anking/gps-station/firmware/readme.md

# GPS base station firmware for ESP32

Turns an ESP32 and a u-blox ZED-F9P into an RTK base station. It finds and configures the module, surveys or uses a fixed position, and sends RTCM corrections over WiFi, straight to rovers on the same network and to an NTRIP caster such as RTK2go as their backup. There is no Raspberry Pi, .NET or Node.js involved.

**Status:** tested against a simulated ZED-F9P and caster, and built for both boards below, but not yet run on real hardware. That includes updates and reporting, which only run on the board. See [First bench test](#first-bench-test).

## What you need

- An ESP32-C3, ESP32-S3 or classic ESP32 board with 4 MB of flash or more
- A ZED-F9P board with its UART1 pins available, and its antenna
- A [mountpoint reservation on RTK2go](http://rtk2go.com/sample-page/new-reservation/), or another caster, for the backup route

## Wiring

| ZED-F9P | ESP32-C3 Super Mini | ESP32-S3 | Classic ESP32 |
| --- | --- | --- | --- |
| RX1 | GPIO 5 | GPIO 17 | GPIO 17 |
| TX1 | GPIO 6 | GPIO 18 | GPIO 16 |
| GND | G | GND | GND |

On a SparkFun GPS-RTK-SMA, RX1 and TX1 are the pads labelled `RX/MOSI` and `TX/MISO`. Leave `CS` unconnected and the `DSEL` jumper on the back open, or those pads stop being a UART. The `RX2` and `TX2` pads under "RTCM Correction" are the module's second port, and will not work here: this firmware configures the module through UART1.

Both sides use 3.3 V logic, so no level shifter is needed. Power the F9P board from its own USB port, or from the ESP32 board's 5 V pin into the F9P board's 5 V pin, with a USB supply good for 1 A. Do not power it from the ESP32 board's 3.3 V pin, and do not plug in both USB ports while that 5 V wire is connected. To use other pins, change `GPS_TX_PIN` and `GPS_RX_PIN` in [platformio.ini](./platformio.ini).

Any baud rate on the module is fine. The firmware finds it and switches to 230400.

The firmware sets the module up at every start, with `UBX-CFG-VALSET` into RAM: its port, its rate, the RTCM messages and the survey or fixed position. That is the only way u-blox documents from module firmware HPG 1.50 on; the older `CFG-PRT`, `CFG-MSG`, `CFG-RATE` and `CFG-TMODE3` messages are not used. Nothing is saved in the module except the second band, when you turn it on from the page. So a module whose settings were wiped, as a firmware update with chip erase does, works straight away.

## Flash it

With [PlatformIO](https://platformio.org/) installed:

```sh
cd firmware
pio run -e esp32-c3 -t upload     # or -e esp32-s3, -e esp32dev
pio device monitor
```

## Set it up

1. On first start the board creates a WiFi network called `gps-base-XXXX`, with the password `gps-base-setup`.
2. Join it and open `http://192.168.4.1`.
3. Fill in your WiFi network, the backup caster details and a password for the page, then save. The board restarts and joins your network.
4. Find its address in your router's device list under `gps-base`, or in the serial monitor, and open it. Log in with any user name and the page password.

If it cannot join your network for 2 minutes, the setup network comes back as well, so a changed router cannot lock it out. Holding the BOOT button for 5 seconds erases all settings.

## Using it

The page shows what it is doing, and in plain words what is wrong if anything is. All settings, and the base mode, survive a restart. It has these tabs:

- **Overview:** whether corrections are going out, to whom, the satellites in use, how many signals are heard on each band, the base's position, a survey's progress, and the WiFi signal.
- **Map:** the base on satellite or street imagery. The map library is stored on the board, so only the imagery comes from the internet, through your phone or computer. On the setup network there is none.
- **Satellites:**
  - where each satellite is in the sky and how strong its signal is. Satellites missing from one side of the sky mean something blocks the antenna there;
  - **Bands:** for each constellation, how many signals are heard on its first band and on its second, how strong they are, and whether the module is set to track each band. See [Two bands](#two-bands).
- **Position:** survey or fixed. For a fixed position:
  - a map to put the base on: tap where the antenna is, or drag the red pin. The blue dot is where the module says it is, and the page says how far apart the two are;
  - **Use the current position** copies where the module is now, to the full precision it reports, and **Use the current height** copies just its height;
  - the height can be given above sea level instead, and is turned into the height above the ellipsoid the module needs.
- **Settings** and **Maintenance:** WiFi, the backup caster, monitoring, updates, installing a firmware file and restarting.

**Survey or fixed position:** corrections make a rover precise *relative to the base*, so the rover's position is only as right and as repeatable as the base's.

- **Survey** works out the position by averaging. It is quick to set up, but the default of 60 seconds and 3 m leaves the base up to metres off, and the result changes with every survey. Anything saved in rover coordinates, such as a mowing boundary, moves with it.
- **Fixed** uses a position you give it. Use this for anything that must line up from day to day. Get the position from a long survey, or from a day of raw data sent to a free service such as [OPUS](https://geodesy.noaa.gov/OPUS/) or [CSRS-PPP](https://webapp.csrs-scrs.nrcan-rncan.gc.ca/geod/tools-outils/ppp.php), or pick it on the map. The antenna must not move afterwards.
  - **On the map:** a point picked there is only as right as the imagery, often a metre or so out. The rovers' positions are then out by the same, but the same every day, which is what matters for anything saved in rover coordinates. Many metres from where the module says it is can make RTK fixed harder for rovers to reach, and the page warns from 5 m.
  - **Heights** are above the ellipsoid, the smooth shape GPS measures from, not above sea level. The two differ by tens of metres depending on where you are: the module's own figure for here is on the page. A survey's height, shown as Height (ellipsoid) on the Overview, is already the right kind. A height from a map or a sign is above sea level: enter it in the sea level box. A height a few metres out moves the rovers' heights, not where they are on the ground.

### Two bands

A rover gets an RTK fix quickly and reliably only when the corrections carry two bands from each satellite: L1 and L2 for GPS and GLONASS, E1 and E5b for Galileo, and B1I and B2I for BeiDou. With the first band alone it can stay at RTK float for a long time, or never fix. The corrections carry only the bands the base hears.

- **If the second band is off in the module,** the Bands card says so and offers **Turn the second band on**. That turns on both bands of every constellation, leaves the constellations themselves as they are, and saves it in the module, so it lasts through a power cut. The module restarts its tracking, so corrections pause for a few seconds. If the module will not save it, it is on until the module loses power, and the page says so. The firmware never changes this by itself.
- **If the second band is on but little is heard on it,** the antenna is probably made for L1 only, or its cable or a splitter loses the higher band. The fix is a multi-band antenna.

Either way, once the base has heard fewer than half as many second-band signals as first-band ones for about 15 seconds, the page and the monitoring service show a warning, `SINGLE_BAND`. It judges only with at least 8 first-band signals heard.

**On an ESP32-C3 Super Mini:** many of these boards are reported to lose WiFi at full power, so this build caps it at 8.5 dBm. That shortens its range, so check the signal on the page with the board where it will finally sit. If it needs more and this board copes, raise `WIFI_MAX_TX_POWER` in [platformio.ini](./platformio.ini).

## How corrections reach a rover

The board sends every correction two ways at once, so a rover can change route at any time:

- **Direct over WiFi:** a rover on the same network connects to this board on port 2101. This needs no internet, password or reservation. Give the board a fixed address on your router, and put that address in the rover's settings, as `NTRIP_DIRECT_SERVER` on the [mower](https://github.com/anking/gps-rider). The page shows the address and whether a rover is connected.
- **Backup caster:** the board also uploads to RTK2go, which needs the internet and the mountpoint password. A rover uses this when it cannot reach the board directly. Leave these settings empty to run with no backup.

Up to two rovers can connect directly. When a third does, the one connected longest is dropped, because a rover that lost its WiFi has no way to say so. A rover that cannot keep up is also dropped, and connects again, so it can never hold up the module or the upload.

Anyone on your WiFi can read the direct stream, which includes the base's exact position. So can anyone at all on RTK2go, while it is set up. Do not forward port 2101 on your router.

## Monitoring and over-the-air updates

The base reports to the [Rider monitoring service](https://rider.solvitcorp.com) over MQTT, and keeps its firmware up to date from there, the same way the solar tracker does. Both are on by default, and only need the board to be on your network.

**Reporting:** the status shown on this page goes to `mqtt.solvitcorp.com` every 5 seconds, including the base's exact position. That broker has no login yet, so anyone connecting to it could read that. To turn reporting off, empty the broker field in the settings. To use a broker with a login, fill in its user and password there.

**Automatic updates:** the board asks the service on start and every 10 minutes. If a newer release is active it installs it and restarts, which drops the corrections for under a minute. Untick the setting to install only when you press **Check for update**, or when someone asks from the service.

- It first checks that the image is this project's, and is for this chip.
- The new version has to run for a minute with a network connection. If it keeps crashing before that, the board goes back to the previous version by itself, and does not install that version again unless someone asks for it by name.
- Firmware comes over plain HTTP, like the tracker's, because an ESP32 cannot reliably hold TLS through a large download. The board checks the image is sound, but not who built it.

To publish a new version, raise `PROJECT_VER` in [CMakeLists.txt](./CMakeLists.txt), build it, and upload `.pio/build/<board>/firmware.bin` on the service's Firmware page. Each chip needs its own build, and the service holds one active release, so all base stations need the same chip.

**By hand:** the page also accepts a `firmware.bin` directly, so a board can be updated without the service.

## How it treats the caster

Public casters count failed connections per IP and ban the address, so the firmware is careful with them:

- Attempts back off from 15 seconds to 15 minutes. The delay only resets after a connection has lasted a minute.
- After a reply that says the IP is banned, it waits an hour.
- It connects only while the module is producing corrections, because a source that connects and sends nothing is dropped and counted as bad.
- It never connects with empty settings. The base carries on without it, serving rovers directly, and the page says so.
- Only whole frames with a valid checksum are sent, as soon as they are complete.

## First bench test

The simulator cannot check real radio, UART timing or WiFi. Before relying on this:

1. Flash it and do the setup above, with the antenna outdoors.
2. The page should go through "Looking for the GPS module" and "Surveying" to "Streaming corrections".
3. Check that your mountpoint appears in the [RTK2go status list](http://rtk2go.com:2101/SNIP::STATUS).
4. Set the rover's `NTRIP_DIRECT_SERVER` to the address on the page. The page should show the rover connected, and the rover should reach RTK Fixed.
5. Pull the WiFi or restart your router, and power cycle the F9P. The page should report it and recover without help each time, and the rover should reconnect by itself.
6. Check that the base appears on the [monitoring service](https://rider.solvitcorp.com), on the map and with its version.
7. Upload a build with a higher version, make it active, and press **Check for update** on the page. The board should install it, restart, and report the new version. Corrections should come back by themselves.
8. Do the same with a build that crashes at start (add `abort();` to the top of `app_main`). The board should come back on the version before it, and report that it will not install that one again. **Keep USB access to the board for this test.**

## Development

The base station's logic is in [src/core](./src/core), which is portable C. The rest of `src/` connects it to the ESP32: UART, WiFi, flash, the web UI, updates ([ota.c](./src/ota.c)) and reporting ([mqtt_link.c](./src/mqtt_link.c)).

To run it on a Linux PC against a simulated module, caster and rover:

```sh
make -C host test    # unit tests
make -C host e2e     # end-to-end scenarios, Linux only
```

These run under AddressSanitizer and exercise the same C code as the firmware, apart from the serial port, the web UI, and the MQTT and update code, which only runs on the board.

On newer kernels AddressSanitizer can crash at random at startup, printing only `AddressSanitizer:DEADLYSIGNAL`, because of how widely addresses are randomised. Run them with randomisation off: `setarch $(uname -m) -R make -C host e2e`. In Docker that also needs `--security-opt seccomp=unconfined`.
