anking/gps-station/enclosure/service-door-v4/README.md

# GPS-станция V4 — ровная дверца, усиления крыши, центрирующая посадка

Предыдущие V1–V3 сохранены отдельно. В V4 семь основных печатных деталей. Пользовательский ESP cradle, сдвижная полка, плоский внутренний пол и глухие крепления сохранены.

## Изменения

* Удалены **две оставшиеся прямоугольные накладки с наружной поверхности дверцы**. Сохранены только её тонкое периметральное ребро и внутренний упор выдвижной полки. Покупные петли и защёлки пользователь размещает самостоятельно.
* **Четыре ската крыши сохраняют исходные ровные наружные плоскости.** Верхушки язычков укорочены, корни обрезаны по наружному контуру крыши. Они больше не выступают через её поверхность. Это не замена четырёхскатной крыши плоской горизонтальной крышкой.
* У каждого из четырёх корней защёлок добавлены **два внутренних ребра толщиной 2.4 мм**, всего восемь. Остальная крыша целиком не утолщалась. По CAD добавленный объём локального усиления составляет примерно **232 мм³ = 0.23 см³**. Расход филамента с поддержками и заполнением зависит от настроек печати.
* В нижнем наружном основании теперь есть **центрирующее гнездо глубиной 2.5 мм** под исходный наружный диаметр адаптера **64 мм**. Диаметр гнезда **64.6 мм**, то есть зазор **0.3 мм на сторону**, без натяга. На входе фаска 0.5 мм.

## Как садится адаптер

Внешний выступ основания увеличен до **Ø70 × 12.5 мм**. Верхние 2.5 мм существующего адаптера входят в гнездо. Точная форма и резьба адаптера сохранены; добавлять отдельный шип или перемоделировать адаптер не потребовалось.

При полностью вставленном адаптере его верхний торец **касается плоского дна гнезда**. Это предусмотренный упор, поэтому осевого зазора между этими поверхностями в собранной CAD-модели нет. Боковой зазор сохраняется: он помогает собрать детали после печати и центрирует их. Объёмного пересечения деталей в номинальном положении нет. Болты удерживают соединение, а посадка уменьшает возможность бокового сдвига.

Три глухих крепления M3 открываются со стороны дна гнезда; карманы под термовставки Ø4.2 × 5 мм и глухой пилот Ø2.5 глубиной 8 мм от посадочного торца сохранены. До внутреннего пола остаётся минимум **6 мм сплошного материала**. Карман сверить с конкретной вставкой. Начальный крепёж — M3 × 10 со стороны открытой резьбовой полости адаптера; проверить фактическую длину и отсутствие упора в дно отверстия.

**`post_register_test.stl`** — небольшая проба самого гнезда; приложить к уже напечатанному адаптеру до печати полного корпуса. В пробе видны отверстия, поскольку это обрезанный тонкий образец. В полноценном корпусе они глухие. Посадку 0.3 мм на сторону при необходимости скорректировать под принтер.

## Крыша

Защёлки остаются встроенными, без болтов: ширина язычка 18, толщина 1.6, длина до корня 21.1 мм. Нижние лапки оттягиваются наружу для снятия крыши. Небольшие внутренние рёбра поддерживают корень; они не заменяют проверку деформации и долговечности пластика.

Сначала проверить `roof_clip_test.stl` и `roof_catch_test.stl`, затем полную крышу с реальной прокладкой. Выбрать ориентацию и поддержки в слайсере; не повредить язычки при удалении поддержек. Свойства зависят от материала и направления слоёв.

## Файлы и Onshape

* `output/gps_station_service_door_v4.step` — основная сборка из семи тел; в Onshape **+ → Import → Combine to a single Part Studio**.
* `output/layout_with_reference_items.step` — сборка плюс приблизительные габариты оборудования; `REFERENCE` не печатать.
* Основные STL: `body`, `door`, `shelf`, `electronics_panel`, `esp_cradle`, `roof`, `post_adapter`.
* `preview.png` — общий вид, `mechanism_detail.png` — разрез посадки адаптера и корень защёлки, `roof_detail.png` — крыша снизу.
* Остальные файлы с `test`/`coupon` — пробные детали для посадок, не части основной сборки.
* STEP содержит редактируемые твёрдые тела, **без нативного дерева параметров Onshape**. Исходники CadQuery 2.8 и `parameters.json` сохранены; часть компоновочных размеров задана в `build.py`.

Слайдеры V3 сохранены: полка 4 мм, слот 4.6 мм, зазор 0.3 мм сверху, снизу и по бокам. Задние упоры ограничивают глубину, внутренний бортик закрытой дверцы ограничивает выдвижение до 1 мм. При открытой дверце полка вытаскивается без винтов; отсоединить проходящие кабели.

Powerbank пока принят 120 × 80 × 25 мм, моток Ø76 × 14 мм — проверить реальные размеры до окончательной печати. Площадка антенны 42 × 42 мм.

Пазы крыши и дверцы: 2.4 × 1.4 мм, шнур Ø2 мм, суммарно около 1.08 м без запаса; купить примерно 1.5 м. В полу сохранён отдельный кабельный ввод Ø16.2 для герметичного сальника. Это отверстие не относится к глухому креплению к столбу.

## Проверки и печать

Проверяются корректность и отсутствие пересечений семи тел, STEP экспорт/импорт, замкнутость печатных сеток, неизменность исходного cradle, плоский пол и глухие крепления, сдвиг полки, попадание крыши в исходные наружные плоскости, боковая посадка и торцевой упор адаптера. Проверки не являются расчётом усилия защёлок, прочности вставок, усталости пластика или водозащиты.

Печатать сначала малые образцы. После сборки проверить пустой корпус с салфеткой внутри под дождём/обливом, без электроники и питания. IP-рейтинг не заявлен. Поддержки и ориентацию корпуса с наружным нижним выступом выбирать в слайсере, проверяя каналы и поверхности уплотнения.

```powershell
.\.cad-venv\Scripts\python.exe enclosure\service-door-v4\build.py
.\.cad-venv\Scripts\python.exe enclosure\service-door-v4\render.py
.\.cad-venv\Scripts\python.exe enclosure\service-door-v4\verify.py
```
