anking/gps-station/enclosure/service-door-v1/README.md

# GPS-станция с боковой дверцей — service-door-v1

Первая CAD-версия для проверки посадок. Поддон powerbank убран. Печатные детали — семь отдельных тел; платы и powerbank доступны через одну боковую дверцу. Исходные пользовательские STEP сохранены без изменений в `inputs/`.

## Что открывать

* `output/gps_station_service_door_v1.step` — семь печатных деталей в собранном положении. В Onshape: **Create → Import files → Combine to a single Part Studio**. STEP содержит редактируемые твёрдые тела, **без исходного дерева эскизов и параметров Onshape**.
* `output/layout_with_reference_items.step` — та же компоновка плюс приблизительные объёмы powerbank, плат, USB-штекера, мотка и антенны. Детали с `REFERENCE` не печатать.
* Семь STL с именами `body`, `door`, `shelf`, `electronics_panel`, `esp_cradle`, `roof`, `post_adapter` — отдельные детали, уже опущены на плоскость печати. STL служит для печати, STEP — для редактирования геометрии.
* `output/preview.png` — изображение CAD-геометрии. Покупная фурнитура, провода и антенна показаны условно; модель отверстий фурнитуры ещё не определена.
* `parameters.json` и `build.py` — исходник CadQuery 2.8. Основные размеры заданы в JSON, часть компоновочных координат — в исходнике. После изменения размеров необходимо повторить проверки; это не готовая параметрическая модель Onshape.

## Компоновка и размеры, мм

| Элемент | Размер / положение |
|---|---|
| Основная оболочка | 170 ширина × 120 глубина × 112 высота |
| Оболочка с наружными площадками фурнитуры | **218 × 132 × 112** |
| Крыша | 182 × 132, подъём 35, верхняя площадка 42 × 42 |
| Собранные печатные части, с креплением на столб | примерно **218 × 138 × 175**, без покупной фурнитуры и антенны |
| Дверца | около 179 × 108, толщина основной стенки 4, с рёбрами и площадками до 12 |
| Проём дверцы | 154 × 96, скруглённые углы |
| Полка | 152 × 104, нижняя плоскость Z=49, толщина 4 |
| Панель плат | 82 × 49, четыре доступных винта крепления |
| Powerbank, условный | **120 × 80 × 25**, опоры на Z=9 |
| Моток кабеля, условный | **Ø76 × 14**, на втором этаже справа |
| USB-штекер, условный | 22 × 12 × 8, у короткого правого торца powerbank |
| GPS | 44 × 43.2; шаг четырёх отверстий **37.75 × 37.75**, измерен из пользовательского STEP основания |
| ESP32 | 18 × 24.7, без припаянных штырьков |
| Крепление на столб | пользовательское Ø64 × 28; настоящая геометрия резьбы сохранена |

Оба этажа находятся в общей рамке, чтобы стык корпусов не пересекал контур уплотнения дверцы. Крыша, дверца, полка, панель, cradle ESP32 и адаптер столба снимаются отдельно. Крышу обычно снимать не требуется. Powerbank удерживается ремешком на неподвижных опорах; после отключения USB и ремешка его можно вынуть через дверцу. Полку и панель можно вынуть через тот же проём, предварительно отсоединив кабели.

**Толщина powerbank и размеры мотка пока не измерены.** При выбранной компоновке геометрический промежуток от опор до полки — 40 мм, но нужен запас на провода, ремешок и установку. Не считать 40 мм допустимой окончательной толщиной аккумулятора. Уточнить реальный USB-штекер и допустимые радиусы изгиба кабелей.

## Выбранная фурнитура

**Петли:** Piutouyar 1 inch, 25 × 25 в раскрытом виде, 304 stainless steel, отверстия по описанию Ø3.35. ASIN **B09LHJ95YS**, две штуки. https://www.amazon.com/dp/B09LHJ95YS

**Защёлки:** модель с пользовательской картинки, красная ручка и регулируемая скоба. Указанный общий размер 3.5 inch = **88.9**, ручка около 0.7 inch = **17.78**, ответная часть ориентировочно 18.29 × 15.24. Две штуки. Это **не** Sugatsune SCC-TF30, под который делался предыдущий подбор.

На картинке защёлок не даны межцентровые расстояния отверстий. Для выбранных петель найден размер отверстий, но не подтверждён их шаг. Поэтому **монтажные площадки фурнитуры намеренно оставлены сплошными**, вместо выдуманной сетки отверстий. Изображение фурнитуры в preview — габаритная схема.

Порядок подгонки:

1. Напечатать пробный участок либо примерить фурнитуру к распечатанному эскизу площадок до печати большого корпуса.
2. Приложить реальные петли и защёлки, проверить положение оси петли и закрытой скобы при установленной прокладке.
3. Перенести фактические центры отверстий в Onshape или разметить их непосредственно по деталям. Проверить боковой зазор и открывание до сверления.
4. Петли крепить винтами M3 с гайками на наружных площадках, если подтвердится диаметр отверстий. Размер крепежа защёлок подобрать по реальным отверстиям, а не по длинным саморезам из комплекта.
5. Площадки защёлок на самой дверце — глухие наружные усиления. **Глубина сверления от внешней поверхности не больше 6 мм**: не пробивать стенку дверцы в сухую полость. Возможны подходящие короткие винты для пластика или закладные вставки после проверки их длины. Сквозные отверстия с гайками допустимы на наружных крыльях, за контуром прокладки.

Полное совпадение фурнитуры и положение её оси можно подтвердить только по реальным деталям или полному чертежу. Проверка открывания CAD использует предварительную ось; не доказывает совместимость конкретной петли до примерки. Если нужны полностью готовые отверстия, нужны их межцентровые размеры.

## Уплотнение и кабели

* Дверца: один непрерывный паз по рамке, 2.4 ширина × 1.4 глубина, под круглый силиконовый шнур **Ø2**, длина по средней линии примерно **515 мм**.
* Крыша: отдельный паз того же сечения, длина около **557 мм**.
* Суммарно требуется около **1.08 м шнура** без запаса; купить **1.5 м**. Ранее обсуждавшихся двух футов хватит только на один контур, не на оба.
* Зазор защёлок настроить так, чтобы дверца сжимала шнур равномерно без заметного изгиба рамки. Номинальное сжатие при полном контакте — 30%; реальное зависит от печати и шнура.
* USB-кабель проходит через отверстие полки 24 × 14. Второе отверстие 22 × 16 предназначено для антенного кабеля, опускающегося к нижнему вводу.
* В полу есть один ввод Ø16.2 под покупной кабельный сальник для антенного кабеля. Проверить монтажный диаметр сальника, длину резьбы и диапазон обжима по фактическому кабелю. Для готового SMA-штекера может потребоваться разъёмный сальник. Шайба и гайка должны помещаться в отведённом месте; в CAD их точных моделей нет.
* После выхода снизу антенный кабель проходит снаружи по задней стороне к антенне. Закрепить его отдельными наружными клипсами; клипсы пока не моделировались. Перед разъединением крыши отсоединить кабель или освободить его запас.
* Четыре винта крыши проходят внутри верхнего контура уплотнения, поэтому им требуются **уплотняющие шайбы под головками** на плоских бобышках. Аналогично герметизировать три утопленных крепежа адаптера столба: они проходят через пол.
* Плоская площадка антенны 42 × 42 не содержит отверстий, поскольку её крепление неизвестно. Размер площадки не определяет требования антенны к металлической подложке; учитывать документацию именно вашей антенны.

Это прототип без подтверждённой степени IP. Проверить пустой корпус с бумажной салфеткой внутри, без электроники и питания, в реальной ориентации под дождём/обливом. Проверять также печатные стенки, стык шнура, ввод и все проходные винты. Конденсат и нагрев на солнце в этой версии не проверялись.

## Остальной крепёж

Предварительные размеры, уточнить по реальной высоте головок и шайб:

* адаптер столба: 3 × M3 примерно 16 мм, гайки со стороны внутренности адаптера; отверстия адаптера увеличены с 3 до 3.3, посадочные места головок в полу Ø6.4 глубиной 2;
* крыша: 4 × M3 около 20 мм с уплотняющими шайбами, в глухие пилоты Ø2.5 под подходящий пластиковой резьбе винт;
* полка: 4 × M3 около 6 мм, в пилоты опор;
* панель плат: 4 × M3 около 8 мм, в глухие задние бобышки;
* GPS: 4 × M2.5 около 6 мм, пилоты Ø2.1 в стойках; убедиться, что отверстия вашей платы соответствуют изменённому основанию;
* cradle ESP32: 2 × M3 около 6 мм; плату удерживает узкая неэлектропроводящая стяжка через пазы, не перекрывающая кнопки и антенну;
* мягкий ремешок для powerbank, отдельный ремешок для мотка.

Пилоты в пластике не являются смоделированной метрической резьбой. Выбранные винты пробовать на образце. Не ставить комплектные саморезы длиной 25 мм в дверцу толщиной 4 мм.

## Печать и проверка

Сначала печатать `seal_fit_coupon.stl`, `gland_fit_coupon.stl`, `electronics_panel.stl` и `esp_cradle.stl`, примерять детали. Большой корпус имеет ширину **218 мм** с крыльями: проверить полезную площадь принтера с учётом юбки/брима. STL корпуса стоит дном вниз. У крыши, верхней перемычки бокового проёма и наружных крыльев могут потребоваться поддержки. Проверить послойный просмотр; не считать комплект поддержек автоматически правильным. Уплотняющие поверхности не должны иметь остатков поддержек и грубых швов.

Для наружной установки предполагается ASA и хорошее сплавление слоёв. Окончательные режимы зависят от принтера и материала. В качестве пробной настройки: слой 0.2, 5–6 периметров, 6 сплошных слоёв сверху/снизу и 30–40% заполнение. Эти режимы не гарантируют водонепроницаемость.

`verification.json` содержит проверки: одна корректная связная твёрдая деталь на каждый STL, отсутствие объёмных пересечений семи деталей и условных габаритов оборудования, STEP экспорт/импорт с сохранением объёма, выборочная проверка поворота дверцы и проходных габаритов полки/панели. Это не расчёт прочности, не проверка реальных компонентов и не испытание на дождь.

Исходник воспроизводится из корня проекта:

```powershell
.\.cad-venv\Scripts\python.exe enclosure\service-door-v1\build.py
.\.cad-venv\Scripts\python.exe enclosure\service-door-v1\render.py
.\.cad-venv\Scripts\python.exe enclosure\service-door-v1\verify.py
```

Официальная справка по импорту STEP: https://cad.onshape.com/help/Content/Document/importing_files.htm
