anking/gps-station/enclosure/service-door-v2/README.md

# GPS-станция — service-door-v2

Новая редакция после пользовательских правок. Версия `service-door-v1` сохранена отдельно.

## Изменения

1. **Крыша без винтов.** Четыре встроенных гибких язычка направлены вниз под свесом крыши; их зацепы защёлкиваются под наружные выступы корпуса. Старые винтовые отверстия, верхние стойки и площадки головок удалены. Паз под уплотнитель крыши сохранён непрерывным.
2. **Убраны только уши под петли слева**, а также накладки петель на дверце. Площадки под ответные части двух выбранных прижимных защёлок справа сохранены, как отдельно подтвердил пользователь. Петли и их отверстия пользователь размещает самостоятельно.
3. **Вернули исходный пользовательский ESP cradle.** Взята деталь `gps_station_B - esp_cradle.step` из пользовательской папки. Она скопирована в `inputs/esp_cradle_user_original.step` и только повёрнута/перенесена, без изменения удерживающих элементов, формы и отверстий. Крепление на панели перенесено под её фактический шаг **31.7 мм**. Геометрия оригинала не перемоделировалась.

## Файлы

* `output/gps_station_service_door_v2.step` — семь печатных тел в собранном положении, для импорта в Onshape: **+ → Import → Combine to a single Part Studio**.
* `output/layout_with_reference_items.step` — дополнительно приблизительные объёмы плат, powerbank, USB-штекера, мотка и антенны. Детали `REFERENCE` не печатать.
* `body.stl`, `door.stl`, `shelf.stl`, `electronics_panel.stl`, `esp_cradle.stl`, `roof.stl`, `post_adapter.stl` — отдельные печатные детали.
* `roof_clip_test.stl` и `roof_catch_test.stl` — небольшие образцы гибкого зацепа и ответного выступа. **Их рекомендуется напечатать первыми** и проверить защёлкивание, усилие освобождения и зазор. Это отдельные пробы, не дополнительные детали окончательной сборки.
* `seal_fit_coupon.stl`, `gland_fit_coupon.stl` — пробы паза уплотнения и кабельного ввода.
* `preview.png` — общий вид CAD. Дверца на правой картинке показана снятой, поскольку петли теперь определяет пользователь. Покупные прижимные защёлки изображены условно.
* `roof_detail.png` — нижние защёлки крыши крупно.
* `verification.json` — результаты проверки тел, пересечений, импорта/экспорта STEP и печатных сеток.

STEP содержит редактируемые твёрдые тела, но **не нативную историю эскизов/параметров Onshape**. Исходник — CadQuery 2.8 (`build.py`, `parameters.json`). Основные размеры заданы в JSON, компоновочные координаты и геометрия зацепов частично заданы непосредственно в исходнике. После любых изменений повторить проверки.

## Крыша и зацепы

Четыре язычка шириной 18 мм, толщиной 1.6 мм, полной длиной до корня 23 мм расположены на левой и правой стенках, по два с каждой стороны. Геометрическое перекрытие удерживающих граней — 0.8 мм; вертикальный люфт между зацепом и ответным выступом в полностью посаженной геометрии — 0.15 мм. Эти размеры являются исходной пробой для принтера, а не подтверждённой характеристикой серийного замка.

При надевании крыши снизу работают наклонные заходные грани. Для снятия **оттянуть нижние свободные концы язычков наружу** и приподнять крышу; сначала освободить пару с одного края, затем оставшуюся пару. За язычки удобно зацепиться выступающими нижними лапками. Не отгибать их дальше необходимого. Не срезать язычки при удалении поддержек.

Проверка CAD подтверждает закрытое положение без объёмного пересечения, но **не моделирует упругое защёлкивание, усталость материала, удерживающее усилие и реальный прижим прокладки**. Это нужно проверить на образцах и затем на крыше. Условный образец может отличаться по поведению от полной крыши из-за ориентации слоёв; использовать соответствующий материал и учитывать направление печати. Подгонка может потребовать изменения зацепа, толщины язычка или зазора в исходнике.

Полная крыша имеет выступающие вниз защёлки. Её ориентацию и поддержки необходимо выбрать в слайсере: автоматически опущенное на стол положение STL не означает, что поддержки не нужны. Особенно проверить опору скатов, основания язычков и чистоту пазов. Для наружной установки предполагается подходящий материал, например ASA; механические свойства зависят от печати.

## Размеры и остальная конструкция

* Главный корпус: **170 × 120 × 112 мм**.
* Корпус с оставшимися площадками защёлок и небольшими ответными выступами крыши: около **197.1 × 132 × 112 мм**.
* Дверца: **176 × 108 мм**, общая толщина с усилениями до 12 мм.
* Крыша со свесами и нижними язычками: около **182.8 × 132 × 55 мм**. Высота крыши над верхом корпуса остаётся 35 мм; зацепы уходят вниз.
* Верхняя площадка под антенну: **42 × 42 мм**, без отверстий, способ крепления антенны ещё не задан.
* Powerbank: условно **120 × 80 × 25 мм**, неподвижные опоры и ремешок. Выдвижного поддона нет.
* Моток антенного кабеля: условно **Ø76 × 14 мм**. Эти два размера по-прежнему требуют проверки по реальным предметам.
* Полка, панель плат, cradle, крыша и адаптер столба остаются съёмными. Винты крепления GPS доступны со стороны бокового проёма.
* Стойки GPS: шаг **37.75 × 37.75 мм** из пользовательского STEP основания.
* Резьбовой адаптер столба — исходная пользовательская геометрия, перевёрнутая отверстием вниз; три отверстия увеличены до 3.3 мм, как в v1.

Cradle в STEP сборки ориентирован вертикально на панели. Это та же исходная деталь размером 22.6 × 37 × 8.4 мм: направление осей и положение изменены, форма сохранена. Для печати её основание уже повернуто к столу. Пилоты крепления на панели — Ø2.5, два винта M3 ориентировочно 6 мм, с проверкой фактической длины. Удерживающие элементы платы уже присутствуют в исходном пользовательском cradle.

## Уплотнение и вводы

Пазы дверцы и крыши: **2.4 мм ширина × 1.4 мм глубина**, круглый силиконовый шнур **Ø2 мм**. Длины по средней линии около 515 мм и 557 мм; суммарно купить примерно **1.5 м с запасом**. Стык шнура выполнить согласно рекомендации поставщика материала.

В крыше теперь нет проходных винтов. Три утопленных крепежа адаптера столба в полу и нижний кабельный ввод всё ещё требуют герметизации. Ввод — Ø16.2, под выбранный покупной сальник; размер монтажной резьбы, длину хвостовика, гайку и обжим кабеля проверить по реальному сальнику.

USB проходит через полку; антенный кабель через отдельный проход опускается к нижнему вводу и затем идёт снаружи к крыше. Перед снятием крыши освободить кабель антенны, чтобы не нагружать разъём.

Прижимные защёлки дверцы и их отверстия по-прежнему подгоняются по реальным деталям: на присланной картинке нет межцентровых расстояний отверстий. Наружные площадки дверцы сверлить глухо, не глубже 6 мм, чтобы не пробить сухую полость. Не ставить длинные саморезы из комплекта непосредственно в тонкую стенку.

Это **прототип без подтверждённой степени IP**. После проверки защёлок проверить пустой собранный корпус с салфеткой внутри в реальной ориентации под дождём/обливом, без электроники и питания. Отдельно проверить равномерность сжатия прокладки: геометрическая посадка крыши сама по себе не гарантирует защиту от воды.

## Проверки и воспроизведение

Проверяются семь корректных связных тел, отсутствие пересечений в собранном положении, условные габариты оборудования, сохранение объёма после STEP экспорт/импорт, проход полки и панели через проём, соответствие объёма и граней cradle оригиналу, замкнутость печатных сеток. Открывание на петлях больше не проверяется, поскольку геометрии петель нет.

Из корня проекта:

```powershell
.\.cad-venv\Scripts\python.exe enclosure\service-door-v2\build.py
.\.cad-venv\Scripts\python.exe enclosure\service-door-v2\render.py
.\.cad-venv\Scripts\python.exe enclosure\service-door-v2\verify.py
```
