anking/gps-station/enclosure/service-door-v4/inputs/post_adapter_original.step

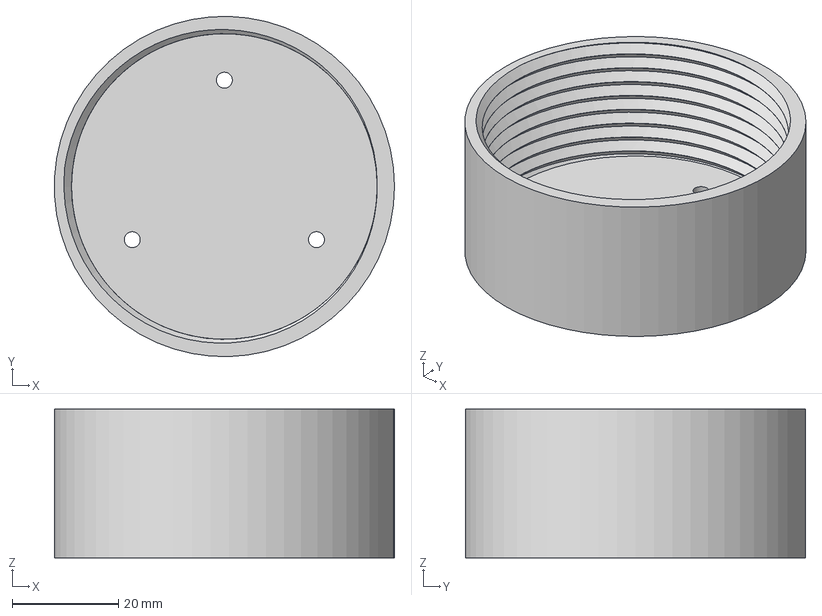
[picture p1: CAD file, 2026-11-09]
enclosure/service-door-v4/inputs/post_adapter_original.step
64.0 x 64.0 x 28.0 mm
