anking/gps-station/enclosure/service-door-v2/inputs/user_base_reference.step

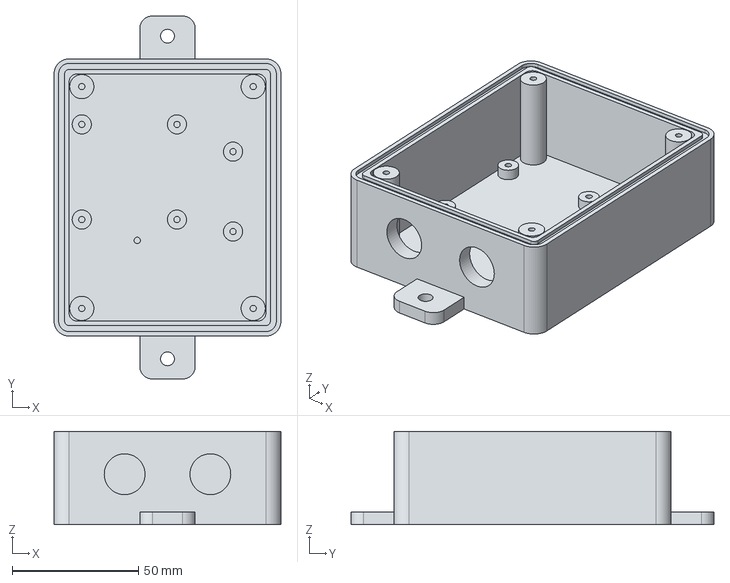
[picture p2: CAD file, 2026-11-09, an earlier design]
enclosure/service-door-v2/inputs/user_base_reference.step
90.0 x 144.0 x 37.0 mm
