anking/gps-station/enclosure/service-door-v2/inputs/esp_cradle_user_original.step

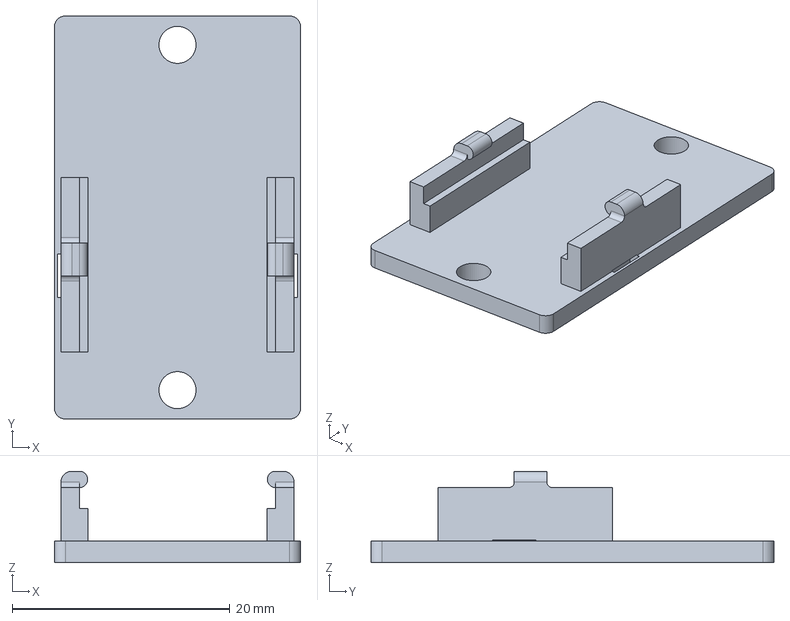
[picture p3: CAD file, 2026-11-09, an earlier design]
enclosure/service-door-v2/inputs/esp_cradle_user_original.step
22.6 x 37.0 x 8.40 mm
