anking/gps-station/firmware/host/core_tests.c

// Tests of the portable firmware core, run on a PC with: make -C firmware/host test
#include <assert.h>
#include <fcntl.h>
#include <stdio.h>
#include <string.h>
#include <sys/socket.h>
#include <unistd.h>

#include "../src/core/base_station.h"
#include "../src/core/caster.h"
#include "../src/core/direct_server.h"
#include "../src/core/fixed_position.h"
#include "../src/core/gnss_stream.h"
#include "../src/core/update_policy.h"

static int failures = 0;

#define CHECK(condition) do { \
        if (!(condition)) { printf("FAILED %s:%d: %s\n", __FILE__, __LINE__, #condition); failures++; } \
    } while (0)

// --- Fixed position ---------------------------------------------------------------------------

static void test_fixed_position(void)
{
    fixed_position_t p;
    const char *error = NULL;

    // A trailing zero that used to move the latitude by a factor of ten
    CHECK(fixed_position_parse("40.123456", "-80.1234567", "300", &p, &error));
    CHECK(p.latitude_e7 == 401234560);
    CHECK(p.latitude_hp == 0);
    CHECK(p.longitude_e7 == -801234567);
    CHECK(p.height_cm == 30000);

    CHECK(fixed_position_parse("40.123456789", "-80.123456789", "300.2567", &p, &error));
    CHECK(p.latitude_e7 == 401234567);
    CHECK(p.latitude_hp == 89);
    CHECK(p.longitude_e7 == -801234567);
    CHECK(p.longitude_hp == -89);
    CHECK(p.height_cm == 30025);
    CHECK(p.height_hp == 67);

    // More digits than the receiver holds are rounded
    CHECK(fixed_position_parse("1.0000000019", "1", "1.00005", &p, &error));
    CHECK(p.latitude_e7 == 10000000);
    CHECK(p.latitude_hp == 2);
    CHECK(p.height_hp == 1);

    CHECK(fixed_position_parse("-0.5", "10", "-12.5", &p, &error));
    CHECK(p.latitude_e7 == -5000000);
    CHECK(p.height_cm == -1250);

    CHECK(fixed_position_parse_combined("-33.8688:151.2093:58.5", &p, &error));
    CHECK(p.latitude_e7 == -338688000);
    CHECK(p.height_cm == 5850);

    const char *bad[][3] = {
        { "91", "0", "0" }, { "-91", "0", "0" }, { "0", "181", "0" }, { "10", "10", "10000" }, { "0", "0", "100" },
        { "abc", "10", "10" }, { "10", "", "10" }, { "10,5", "10", "10" }, { "1e1", "10", "10" }, { "1.", "10", "10" },
        { "--1", "10", "10" }, { ".5", "10", "10" }, { "1234567890", "10", "10" },
    };
    for (size_t i = 0; i < sizeof(bad) / sizeof(bad[0]); i++) {
        CHECK(!fixed_position_parse(bad[i][0], bad[i][1], bad[i][2], &p, &error));
    }
    CHECK(!fixed_position_parse(NULL, "1", "1", &p, &error));

    CHECK(!fixed_position_parse_combined("1:2", &p, &error));
    CHECK(!fixed_position_parse_combined("1:2:3:4", &p, &error));
    CHECK(!fixed_position_parse_combined("", &p, &error));
}

// --- Stream ----------------------------------------------------------------------------------

static int ubx_count;
static uint8_t ubx_cls, ubx_id;
static uint16_t ubx_length;
static uint8_t ubx_first;
static int rtcm_count;
static uint16_t rtcm_length;

static void count_ubx(void *ctx, uint8_t cls, uint8_t id, const uint8_t *payload, uint16_t length)
{
    (void)ctx;
    ubx_count++;
    ubx_cls = cls;
    ubx_id = id;
    ubx_length = length;
    ubx_first = length ? payload[0] : 0;
}

static void count_rtcm(void *ctx, const uint8_t *frame, uint16_t length)
{
    (void)ctx;
    (void)frame;
    rtcm_count++;
    rtcm_length = length;
}

static size_t make_rtcm(uint8_t *out, uint16_t payload_length)
{
    out[0] = 0xD3;
    out[1] = (uint8_t)(payload_length >> 8);
    out[2] = (uint8_t)payload_length;
    memset(out + 3, 0x5A, payload_length);
    uint32_t crc = rtcm_crc24q(out, (size_t)payload_length + 3);
    out[payload_length + 3] = (uint8_t)(crc >> 16);
    out[payload_length + 4] = (uint8_t)(crc >> 8);
    out[payload_length + 5] = (uint8_t)crc;
    return (size_t)payload_length + 6;
}

static void reset_counts(gnss_stream_t *stream)
{
    gnss_stream_init(stream, count_ubx, count_rtcm, NULL);
    ubx_count = rtcm_count = 0;
}

static void test_stream(void)
{
    gnss_stream_t stream;
    uint8_t frame[RTCM_MAX_FRAME + 32];

    // The CRC of the published example vector for CRC-24Q
    const uint8_t vector[] = "123456789";
    CHECK(rtcm_crc24q(vector, 9) == 0xCDE703);

    // A frame built here parses back
    reset_counts(&stream);
    uint8_t payload[] = { 7, 8, 9 };
    size_t length = ubx_frame(frame, sizeof(frame), 0x06, 0x08, payload, 3);
    CHECK(length == 11);
    gnss_stream_feed(&stream, frame, length);
    CHECK(ubx_count == 1 && ubx_cls == 0x06 && ubx_id == 0x08 && ubx_length == 3 && ubx_first == 7);

    // The published checksum of a UBX-CFG-RATE poll
    length = ubx_frame(frame, sizeof(frame), 0x06, 0x08, NULL, 0);
    CHECK(frame[6] == 0x0E && frame[7] == 0x30);

    // A frame that does not fit is refused
    CHECK(ubx_frame(frame, 5, 0x06, 0x08, NULL, 0) == 0);

    // One byte at a time, with noise before and between
    reset_counts(&stream);
    uint8_t noise[] = { 0x00, 0xB5, 0x00, 0x62, 0xFF, 0xD3, 0xFF };
    gnss_stream_feed(&stream, noise, sizeof(noise));
    length = make_rtcm(frame, 100);
    for (size_t i = 0; i < length; i++) gnss_stream_feed(&stream, frame + i, 1);
    CHECK(rtcm_count == 1 && rtcm_length == 106);

    // The longest frame
    reset_counts(&stream);
    length = make_rtcm(frame, 1023);
    gnss_stream_feed(&stream, frame, length);
    CHECK(rtcm_count == 1 && rtcm_length == 1029);

    // Damage is never passed on, and the next frame still gets through
    reset_counts(&stream);
    length = make_rtcm(frame, 50);
    frame[10] ^= 0x01;
    gnss_stream_feed(&stream, frame, length);
    CHECK(rtcm_count == 0 && stream.rtcm_errors == 1);
    length = make_rtcm(frame, 50);
    gnss_stream_feed(&stream, frame, length);
    CHECK(rtcm_count == 1);

    reset_counts(&stream);
    length = ubx_frame(frame, sizeof(frame), 0x06, 0x08, payload, 3);
    frame[length - 1] ^= 0x01;
    gnss_stream_feed(&stream, frame, length);
    CHECK(ubx_count == 0 && stream.ubx_errors == 1);

    // A message too long to keep is stepped over and the stream stays in step
    reset_counts(&stream);
    uint8_t header[] = { 0xB5, 0x62, 0x0A, 0x04, 0x00, 0x10 }; // 4096 bytes, more than the longest signal list
    gnss_stream_feed(&stream, header, sizeof(header));
    static uint8_t filler[4096 + 2];
    gnss_stream_feed(&stream, filler, sizeof(filler));
    length = ubx_frame(frame, sizeof(frame), 0x01, 0x07, payload, 3);
    gnss_stream_feed(&stream, frame, length);
    CHECK(ubx_count == 1 && ubx_cls == 0x01);
}

// --- Caster protocol ---------------------------------------------------------------------------

static void test_caster_protocol(void)
{
    char request[128];
    caster_build_source_request(request, sizeof(request), "MOUNT", "secret");
    CHECK(strncmp(request, "SOURCE secret /MOUNT\r\n", 22) == 0);
    CHECK(strlen(request) >= 4 && strcmp(request + strlen(request) - 4, "\r\n\r\n") == 0);

    CHECK(caster_classify_reply("ICY 200 OK\r\n") == CASTER_REPLY_OK);
    CHECK(caster_classify_reply("HTTP/1.1 200 OK\r\n\r\n") == CASTER_REPLY_OK);
    CHECK(caster_classify_reply("SOURCETABLE 200 OK\r\n") == CASTER_REPLY_SOURCETABLE);
    CHECK(caster_classify_reply("HTTP/1.1 403 Forbidden\r\n\r\nYour IP is BANNED") == CASTER_REPLY_BANNED);
    CHECK(caster_classify_reply("ERROR - Bad Password\r\n") == CASTER_REPLY_REJECTED);
    CHECK(caster_classify_reply("HTTP/1.1 401 Unauthorized\r\n") == CASTER_REPLY_REJECTED);
    CHECK(caster_classify_reply("") == CASTER_REPLY_REJECTED);
}

// --- Status ------------------------------------------------------------------------------------

static void no_write(void *ctx, const uint8_t *data, size_t length) { (void)ctx; (void)data; (void)length; }
static void no_baud(void *ctx, uint32_t baud) { (void)ctx; (void)baud; }
static bool no_network(void *ctx) { (void)ctx; return false; }

static void test_not_configured(void)
{
    static base_station_t base;
    base_hal_t hal = { .serial_write = no_write, .serial_set_baud = no_baud, .network_ready = no_network };
    base_caster_settings_t settings = { .port = 2101 };
    base_mode_t mode = { .kind = BASE_MODE_SURVEY, .survey_accuracy_mm = 3000, .survey_seconds = 60 };

    base_init(&base, &hal, &settings, &mode, 0);
    base_tick(&base, 1000);

    char json[1024];
    int length = base_status_json(&base, json, sizeof(json));
    CHECK(length > 0 && (size_t)length < sizeof(json));
    // The caster is only the backup, so the base still gets on with its job
    CHECK(strstr(json, "\"phase\":\"finding_module\"") != NULL);
    CHECK(strstr(json, "NTRIP_NOT_CONFIGURED") != NULL);

    // Text from a caster cannot break the JSON
    strcpy(base.caster.message, "bad \"quote\" \\ here");
    base_status_json(&base, json, sizeof(json));
    CHECK(strstr(json, "\"caster_message\":\"bad  quote    here\"") != NULL);
}

// --- What the page shows --------------------------------------------------------------------------

static void feed_message(base_station_t *base, uint8_t cls, uint8_t id, const uint8_t *payload, uint16_t length)
{
    static uint8_t frame[UBX_MAX_PAYLOAD + UBX_OVERHEAD];
    size_t total = ubx_frame(frame, sizeof(frame), cls, id, payload, length);
    CHECK(total > 0);
    base_on_serial(base, frame, total);
}

static void feed_ubx(base_station_t *base, uint8_t id, const uint8_t *payload, uint16_t length)
{
    feed_message(base, UBX_CLASS_NAV, id, payload, length);
}

static void put_le32(uint8_t *p, int32_t value)
{
    uint32_t v = (uint32_t)value;
    p[0] = (uint8_t)v; p[1] = (uint8_t)(v >> 8); p[2] = (uint8_t)(v >> 16); p[3] = (uint8_t)(v >> 24);
}

static void test_page_data(void)
{
    static base_station_t base;
    base_hal_t hal = { .serial_write = no_write, .serial_set_baud = no_baud, .network_ready = no_network };
    base_caster_settings_t settings = { .port = 2101 };
    base_mode_t mode = { .kind = BASE_MODE_SURVEY, .survey_accuracy_mm = 3000, .survey_seconds = 60 };
    base_init(&base, &hal, &settings, &mode, 0);
    base_tick(&base, 1000);

    char json[1700];
    CHECK(base_sky_json(&base, json, sizeof(json)) > 0);
    CHECK(strcmp(json, "{\"age_ms\":-1,\"sats\":[]}") == 0);

    // The exact position, with the extra digits the module sends separately, and negative ones too
    uint8_t position[36] = { 0 };
    put_le32(position + 8, 1512093000);     // longitude, 1e-7 degrees
    put_le32(position + 12, -338688000);    // latitude
    put_le32(position + 16, 58500);         // height above the ellipsoid, mm
    put_le32(position + 20, 36400);         // above sea level, mm: the geoid is 22 m above the ellipsoid in Sydney
    position[24] = 7;                       // longitude, 1e-9
    position[25] = (uint8_t)(int8_t)-12;    // latitude, 1e-9
    position[26] = 3;                       // height, 0.1 mm
    position[27] = (uint8_t)(int8_t)-2;     // above sea level, 0.1 mm
    feed_ubx(&base, UBX_NAV_HPPOSLLH, position, sizeof(position));

    int length = base_status_json(&base, json, sizeof(json));
    CHECK(strstr(json, "\"lat\":-33.868800012,") != NULL);
    CHECK(strstr(json, "\"lon\":151.209300007,") != NULL);
    CHECK(strstr(json, "\"height_m\":58.5003,") != NULL);
    CHECK(strstr(json, "\"height_msl_m\":36.3998,") != NULL);

    // The web page and MQTT each keep a margin after the status for what they add
    CHECK(length > 0 && length < 1100);

    // A position just south of the equator still has its sign
    memset(position + 8, 0, 8);
    position[25] = (uint8_t)(int8_t)-5;
    position[24] = 0;
    feed_ubx(&base, UBX_NAV_HPPOSLLH, position, sizeof(position));
    base_status_json(&base, json, sizeof(json));
    CHECK(strstr(json, "\"lat\":-0.000000005,") != NULL);

    // The satellite list: 40 satellites is more than the old limit on a message's length
    uint8_t sky[8 + 12 * 40] = { 0 };
    sky[5] = 40;
    for (int i = 0; i < 40; i++) {
        uint8_t *entry = sky + 8 + 12 * i;
        entry[0] = (uint8_t)(i % 4 == 3 ? 6 : i % 4);
        entry[1] = (uint8_t)(i + 1);
        entry[2] = (uint8_t)(20 + i);
        entry[3] = (uint8_t)(int8_t)(i == 39 ? -91 : 5 + i);
        entry[4] = (uint8_t)((i * 9) & 0xFF);
        entry[5] = (uint8_t)((i * 9) >> 8);
        entry[8] = i % 2 == 0 ? 0x08 : 0x00;
    }
    base_tick(&base, 1500);
    feed_ubx(&base, UBX_NAV_SAT, sky, sizeof(sky));
    base_tick(&base, 1700);

    length = base_sky_json(&base, json, sizeof(json));
    CHECK(length > 0 && (size_t)length < sizeof(json));
    CHECK(strncmp(json, "{\"age_ms\":200,\"sats\":[[0,1,20,5,0,1],[1,2,21,6,9,0],", 47) == 0);
    CHECK(strstr(json, "[6,40,59,-91,351,0]]}") != NULL);

    // The whole list from a full sky fits the page's buffer
    uint8_t full[8 + 12 * BASE_MAX_SATELLITES];
    memset(full, 0xFF, sizeof(full));
    full[5] = BASE_MAX_SATELLITES;
    feed_ubx(&base, UBX_NAV_SAT, full, sizeof(full));
    length = base_sky_json(&base, json, sizeof(json));
    CHECK(length > 0 && (size_t)length < sizeof(json));
}

// --- Bands -------------------------------------------------------------------------------------

static void put_signal(uint8_t *message, int index, uint8_t gnss, uint8_t id, uint8_t signal, uint8_t cno, bool used)
{
    uint8_t *entry = message + 8 + 16 * index;
    memset(entry, 0, 16);
    entry[0] = gnss;
    entry[1] = id;
    entry[2] = signal;
    entry[6] = cno;
    entry[10] = used ? 0x08 : 0x00;
    message[5] = (uint8_t)(index + 1);
}

// A sky with this many GPS satellites heard on L1, and the first of them on L2 as well
static void feed_sky_bands(base_station_t *base, int first, int second)
{
    static uint8_t message[8 + 16 * 64];
    memset(message, 0, sizeof(message));
    int index = 0;
    for (int i = 0; i < first; i++) put_signal(message, index++, 0, (uint8_t)(i + 1), 0, 40, true);
    for (int i = 0; i < second; i++) put_signal(message, index++, 0, (uint8_t)(i + 1), 3, 35, false);
    feed_ubx(base, UBX_NAV_SIG, message, (uint16_t)(8 + 16 * index));
}

// The module's answer to the band settings asked for, with the second band of the constellations given switched off
static void feed_band_settings(base_station_t *base, bool gps_second, bool others_second, bool qzss_second, int leave_out)
{
    static const uint32_t KEYS[][3] = {
        { 0x1031001F, 0x10310001, 0x10310003 }, { 0x10310021, 0x10310007, 0x1031000A }, { 0x10310022, 0x1031000D, 0x1031000E },
        { 0x10310025, 0x10310018, 0x1031001A }, { 0x10310024, 0x10310012, 0x10310015 },
    };
    uint8_t payload[4 + 5 * 15] = { 1, 0, 0, 0 };
    size_t at = 4;
    for (int i = 0; i < 5; i++) {
        for (int which = 0; which < 3; which++) {
            if (3 * i + which == leave_out) continue;
            put_le32(payload + at, (int32_t)KEYS[i][which]);
            payload[at + 4] = which < 2 ? 1 : i == 0 ? gps_second : i == 4 ? qzss_second : others_second;
            at += 5;
        }
    }
    feed_message(base, UBX_CLASS_CFG, UBX_CFG_VALGET, payload, (uint16_t)at);
}

static void test_bands(void)
{
    static base_station_t base;
    base_hal_t hal = { .serial_write = no_write, .serial_set_baud = no_baud, .network_ready = no_network };
    base_caster_settings_t settings = { .port = 2101 };
    base_mode_t mode = { .kind = BASE_MODE_SURVEY, .survey_accuracy_mm = 3000, .survey_seconds = 60 };
    base_init(&base, &hal, &settings, &mode, 0);
    base_tick(&base, 1000);

    static char json[3400];
    CHECK(base_signals_json(&base, json, sizeof(json)) > 0);
    CHECK(strcmp(json, "{\"age_ms\":-1,\"settings_age_ms\":-1,\"second_band\":\"unknown\",\"request\":\"none\",\"settings\":[],\"signals\":[]}") == 0);

    // Not until the module is found and configured
    CHECK(!base_enable_second_band(&base));
    CHECK(base.bands_request == BASE_BANDS_IDLE);

    // Each band of each constellation, one signal searched for but not heard, and signals that are in no band
    static uint8_t message[8 + 16 * 16];
    memset(message, 0, sizeof(message));
    put_signal(message, 0, 0, 1, 0, 40, true);      // GPS L1C/A
    put_signal(message, 1, 0, 1, 3, 30, false);     // GPS L2C
    put_signal(message, 2, 2, 5, 0, 44, true);      // Galileo E1
    put_signal(message, 3, 2, 5, 5, 38, false);     // Galileo E5b
    put_signal(message, 4, 3, 20, 0, 35, false);    // BeiDou B1I
    put_signal(message, 5, 3, 20, 2, 0, false);     // BeiDou B2I, not heard
    put_signal(message, 6, 6, 3, 0, 33, false);     // GLONASS L1
    put_signal(message, 7, 6, 3, 2, 25, false);     // GLONASS L2
    put_signal(message, 8, 1, 133, 0, 30, false);   // SBAS
    put_signal(message, 9, 2, 5, 3, 30, false);     // Galileo E5a, which this module does not have
    base_tick(&base, 2000);
    feed_ubx(&base, UBX_NAV_SIG, message, 8 + 16 * 10);
    base_tick(&base, 2300);

    base_signals_json(&base, json, sizeof(json));
    CHECK(strstr(json, "{\"age_ms\":300,") == json);
    CHECK(strstr(json, "\"signals\":[[0,1,1,40,1],[0,1,2,30,0],[2,5,1,44,1],[2,5,2,38,0],[3,20,1,35,0],[6,3,1,33,0],[6,3,2,25,0],"
                       "[1,133,0,30,0],[2,5,0,30,0]]}") != NULL);

    base_status_json(&base, json, sizeof(json));
    CHECK(strstr(json, "\"bands\":{\"second\":\"unknown\",\"l1\":[4,2,40],\"l2\":[3,0,30]}") != NULL);

    // L1 only, as from an antenna made for it: a warning once it has lasted, so not while the second band comes back
    feed_sky_bands(&base, 12, 0);
    feed_sky_bands(&base, 12, 0);
    base_status_json(&base, json, sizeof(json));
    CHECK(strstr(json, "SINGLE_BAND") == NULL);
    feed_sky_bands(&base, 12, 0);
    base_status_json(&base, json, sizeof(json));
    CHECK(strstr(json, "\"errors\":[\"NTRIP_NOT_CONFIGURED\",\"SINGLE_BAND\"]") != NULL);
    CHECK(strstr(json, "\"l1\":[12,12,40],\"l2\":[0,0,0]") != NULL);

    // Gone as soon as the second band is heard
    feed_sky_bands(&base, 12, 9);
    base_status_json(&base, json, sizeof(json));
    CHECK(strstr(json, "SINGLE_BAND") == NULL);

    // A weak second band is a warning too, but a sky with few satellites is not judged
    for (int i = 0; i < 3; i++) feed_sky_bands(&base, 12, 5);
    CHECK(base.errors & BASE_ERROR_SINGLE_BAND);
    for (int i = 0; i < 3; i++) feed_sky_bands(&base, 7, 0);
    CHECK(!(base.errors & BASE_ERROR_SINGLE_BAND));

    // The module's settings: the second band off everywhere, as found on a base that sent L1 only
    feed_band_settings(&base, false, false, false, -1);
    base_signals_json(&base, json, sizeof(json));
    CHECK(strstr(json, "\"second_band\":\"off\"") != NULL);
    CHECK(strstr(json, "\"settings\":[[0,1,1,0],[2,1,1,0],[3,1,1,0],[6,1,1,0],[5,1,1,0]]") != NULL);
    base_status_json(&base, json, sizeof(json));
    CHECK(strstr(json, "\"bands\":{\"second\":\"off\",") != NULL);

    feed_band_settings(&base, true, false, false, -1);
    base_signals_json(&base, json, sizeof(json));
    CHECK(strstr(json, "\"second_band\":\"partly\"") != NULL);

    // QZSS is not seen here, so its second band does not count
    feed_band_settings(&base, true, true, false, -1);
    base_signals_json(&base, json, sizeof(json));
    CHECK(strstr(json, "\"second_band\":\"on\"") != NULL);

    // An answer missing a setting changes nothing
    feed_band_settings(&base, false, false, false, 5);
    base_signals_json(&base, json, sizeof(json));
    CHECK(strstr(json, "\"second_band\":\"on\"") != NULL);

    // The longest signal list the module can send, of the longest numbers, still fits the page's buffer
    static uint8_t full[8 + 16 * 255];
    memset(full, 0xFF, sizeof(full));
    full[5] = 255;
    feed_ubx(&base, UBX_NAV_SIG, full, sizeof(full));
    CHECK(base.signal_count == BASE_MAX_SIGNALS);
    base.bands_request = BASE_BANDS_ON_FOR_NOW;
    int length = base_signals_json(&base, json, sizeof(json));
    CHECK(length > 0 && (size_t)length < sizeof(json));

    // The status still leaves the web page and MQTT their margin
    length = base_status_json(&base, json, sizeof(json));
    CHECK(length > 0 && length < 1100);
}

// --- Setting up the module -----------------------------------------------------------------------

static uint8_t sent[64][128];
static size_t sent_length[64];
static int sent_count;

static void record_write(void *ctx, const uint8_t *data, size_t length)
{
    (void)ctx;
    if (sent_count < 64 && length <= sizeof(sent[0])) {
        memcpy(sent[sent_count], data, length);
        sent_length[sent_count++] = length;
    }
}

// The value given for this key in a CFG-VALSET frame, or -1 when the key is not in it
static int64_t valset_value(const uint8_t *frame, size_t length, uint32_t key)
{
    if (length < 12 || frame[2] != UBX_CLASS_CFG || frame[3] != UBX_CFG_VALSET) return -1;
    static const uint8_t SIZES[] = { 0, 1, 1, 2, 4 };
    size_t end = length - 2;
    for (size_t at = 6 + 4; at + 4 <= end;) {
        uint32_t k = (uint32_t)frame[at] | ((uint32_t)frame[at + 1] << 8) | ((uint32_t)frame[at + 2] << 16) | ((uint32_t)frame[at + 3] << 24);
        uint8_t size = SIZES[(k >> 28) & 7u];
        if (k == key) {
            int64_t value = 0;
            for (uint8_t i = 0; i < size; i++) value |= (int64_t)frame[at + 4 + i] << (8 * i);
            return value;
        }
        at += 4u + size;
    }
    return -1;
}

static void feed_ack(base_station_t *base, uint8_t id)
{
    uint8_t ack[2] = { UBX_CLASS_CFG, id };
    feed_message(base, UBX_CLASS_ACK, UBX_ACK_ACK, ack, 2);
}

static void test_configuration_messages(void)
{
    static base_station_t base;
    base_hal_t hal = { .serial_write = record_write, .serial_set_baud = no_baud, .network_ready = no_network };
    base_caster_settings_t settings = { .port = 2101 };
    base_mode_t mode = { .kind = BASE_MODE_FIXED };
    const char *error = NULL;
    CHECK(fixed_position_parse("40.602809870", "-80.073553310", "293.0042", &mode.fixed, &error));
    sent_count = 0;
    base_init(&base, &hal, &settings, &mode, 0);

    // Looking for the module: it asks for one setting, the measurement rate, at the first speed tried
    base_tick(&base, 1000);
    CHECK(sent_count == 1 && sent[0][2] == UBX_CLASS_CFG && sent[0][3] == UBX_CFG_VALGET);
    CHECK(sent_length[0] == 8 + 8 && sent[0][10] == 0x01 && sent[0][13] == 0x30);

    // Any answer finds it. Each step is a CFG-VALSET to RAM, sent once the one before is acknowledged.
    uint8_t answer[10] = { 1, 0, 0, 0, 0x01, 0x00, 0x21, 0x30, 0xE8, 0x03 };
    feed_message(&base, UBX_CLASS_CFG, UBX_CFG_VALGET, answer, sizeof(answer));
    static char json[1500];
    int before = sent_count;
    for (int i = 0; i < 20; i++) {
        base_tick(&base, 1100 + 10 * i);
        if (sent_count > before) {
            before = sent_count;
            feed_ack(&base, UBX_CFG_VALSET);
        }
        base_status_json(&base, json, sizeof(json));
        if (strstr(json, "\"phase\":\"running\"") != NULL) break;
    }
    CHECK(strstr(json, "\"phase\":\"running\"") != NULL);
    CHECK(sent_count == 1 + 5 + 1);

    for (int i = 1; i < sent_count; i++) {
        CHECK(sent[i][2] == UBX_CLASS_CFG && sent[i][3] == UBX_CFG_VALSET);
        CHECK(sent[i][7] == 0x01);    // RAM
    }

    // The port: UART1 at 230400, UBX, NMEA and RTCM3 in, and UBX and RTCM3 out with no NMEA
    CHECK(valset_value(sent[1], sent_length[1], 0x40520001) == 230400);
    CHECK(valset_value(sent[1], sent_length[1], 0x10730002) == 1);
    CHECK(valset_value(sent[1], sent_length[1], 0x10740001) == 1);
    CHECK(valset_value(sent[1], sent_length[1], 0x10740002) == 0);
    CHECK(valset_value(sent[1], sent_length[1], 0x10740004) == 1);

    // One measurement a second, on GPS time
    CHECK(valset_value(sent[2], sent_length[2], 0x30210001) == 1000);
    CHECK(valset_value(sent[2], sent_length[2], 0x30210002) == 1);
    CHECK(valset_value(sent[2], sent_length[2], 0x20210003) == 1);

    // Every correction message off, then the mode off, then fixed at the position, to the last digit
    CHECK(valset_value(sent[3], sent_length[3], 0x2091035F) == 0);
    CHECK(valset_value(sent[3], sent_length[3], 0x20910304) == 0);
    CHECK(valset_value(sent[4], sent_length[4], 0x20030001) == 0);
    CHECK(valset_value(sent[5], sent_length[5], 0x20030001) == 2);
    CHECK(valset_value(sent[5], sent_length[5], 0x20030002) == 1);
    CHECK(valset_value(sent[5], sent_length[5], 0x40030009) == 406028098);
    CHECK(valset_value(sent[5], sent_length[5], 0x4003000A) == (uint32_t)-800735533);
    CHECK(valset_value(sent[5], sent_length[5], 0x4003000B) == 29300);
    CHECK(valset_value(sent[5], sent_length[5], 0x2003000C) == 70);
    CHECK(valset_value(sent[5], sent_length[5], 0x2003000D) == (uint8_t)(int8_t)-10);
    CHECK(valset_value(sent[5], sent_length[5], 0x2003000E) == 42);

    // Then the corrections on: MSM4 for each constellation and the position every second, the GLONASS biases every 10
    const uint32_t ONCE_A_SECOND[] = { 0x209102BE, 0x2091035F, 0x20910364, 0x20910369, 0x2091036E };
    for (size_t i = 0; i < 5; i++) CHECK(valset_value(sent[6], sent_length[6], ONCE_A_SECOND[i]) == 1);
    CHECK(valset_value(sent[6], sent_length[6], 0x20910304) == 10);
}

// --- Direct link -------------------------------------------------------------------------------

static void test_direct_requests(void)
{
    CHECK(direct_is_stream_request("GET /base HTTP/1.0\r\n\r\n"));
    CHECK(direct_is_stream_request("GET /anything HTTP/1.1\r\n\r\n"));
    CHECK(!direct_is_stream_request("GET / HTTP/1.0\r\n\r\n"));
    CHECK(!direct_is_stream_request("GET /"));
    CHECK(!direct_is_stream_request("SOURCE secret /base\r\n\r\n"));
    CHECK(!direct_is_stream_request("POST /base HTTP/1.0\r\n\r\n"));
    CHECK(!direct_is_stream_request(""));
}

static void test_direct_drops_a_stuck_rover(void)
{
    int ends[2];
    CHECK(socketpair(AF_UNIX, SOCK_STREAM, 0, ends) == 0);
    fcntl(ends[0], F_SETFL, fcntl(ends[0], F_GETFL, 0) | O_NONBLOCK);

    static direct_server_t server;
    direct_server_init(&server, 0);
    server.rovers[0].fd = ends[0];
    server.rovers[0].streaming = true;
    CHECK(direct_server_rover_count(&server) == 1);

    // Nothing reads the other end, so this fills up. It must never wait for it, or the GPS module would be held up.
    static const uint8_t frame[1000];
    for (int i = 0; i < 100000 && direct_server_rover_count(&server) == 1; i++) direct_server_send(&server, frame, sizeof(frame));

    CHECK(direct_server_rover_count(&server) == 0);
    CHECK(server.rovers[0].fd == -1);
    close(ends[1]);
}

// --- Updates -----------------------------------------------------------------------------------

static void test_update_policy(void)
{
    const char *us = "gps-base-station";

    CHECK(update_decide(us, "1.1.0", us, "1.2.0", "", false) == UPDATE_INSTALL);

    // The server can offer an older build, when someone pins it or activates it to roll back
    CHECK(update_decide(us, "1.2.0", us, "1.1.0", "", true) == UPDATE_INSTALL);

    CHECK(update_decide(us, "1.1.0", us, "1.1.0", "", false) == UPDATE_SKIP_SAME_VERSION);
    CHECK(update_decide(us, "1.1.0", us, "1.1.0", "", true) == UPDATE_SKIP_SAME_VERSION);

    // Never another device's firmware, even when asked for by id
    CHECK(update_decide(us, "1.1.0", "SolarControlV2", "9.9.9", "", false) == UPDATE_REFUSE_WRONG_PROJECT);
    CHECK(update_decide(us, "1.1.0", "SolarControlV2", "9.9.9", "", true) == UPDATE_REFUSE_WRONG_PROJECT);

    // A release that rolled back is not installed again by itself, but a later one is, and it can be retried on purpose
    CHECK(update_decide(us, "1.1.0", us, "1.2.0", "1.2.0", false) == UPDATE_REFUSE_FAILED_BEFORE);
    CHECK(update_decide(us, "1.1.0", us, "1.2.1", "1.2.0", false) == UPDATE_INSTALL);
    CHECK(update_decide(us, "1.1.0", us, "1.2.0", "1.2.0", true) == UPDATE_INSTALL);
}

int main(void)
{
    test_fixed_position();
    test_stream();
    test_caster_protocol();
    test_not_configured();
    test_page_data();
    test_bands();
    test_configuration_messages();
    test_direct_requests();
    test_direct_drops_a_stuck_rover();
    test_update_policy();

    printf(failures ? "%d FAILED\n" : "all core tests passed\n", failures);
    return failures ? 1 : 0;
}
