anking/gps-station/(commit log)

2020-11-08 added locatioon service and proper device trigger for plug/unplug
2020-11-13 gps socket integration with .net on node side - needs completed
2020-11-14 server side enhancements: multiple sockets added for handling NMEA, RTCM and SYNC streams
2020-11-14 added compiled version of f9p driver for linux-arm
2020-11-18 bugfix with socket files removal
2020-12-04 updates/ power/on/off
2025-02-13 statuin UI fixes and socket incompat
2026-11-07 Recover by itself, protect the UI, fix fixed mode, update Node and packages
    Base mode:
    - Send fixed positions exactly as typed. Going through parseFloat and appending 000 moved the latitude by a factor
    of ten when the position ended in a zero, and made the height ten times too high.
    - Keep the chosen mode across restarts, and add BASE_FIXED_POSITION to .env, so a base never quietly re-surveys.
    Reliability:
    - Listen on the sync socket before starting the driver.
    - Restart the driver with a growing delay, and the GPS process after 5 s, instead of immediately.
    Restart loops also restarted the driver's caster backoff, which risks an IP ban on RTK2go.
    - Wait for the module to appear instead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
2026-11-07 Add ESP32 base station firmware, replacing the Raspberry Pi
    The base station only configures the module, streams corrections and serves a status page, so it does not need a
    Linux computer, .NET or Node.js. It now runs as C firmware on an ESP32-S3 or classic ESP32, wired to the module's UART.
    - src/core is portable C: finding and configuring the module, survey and fixed modes, the caster connection.
    It compiles for a PC too, so it is tested against a simulated ZED-F9P and caster under AddressSanitizer.
    - Same caster rules as the fixed Pi driver: back off from 15 s to 15 min, wait an hour after a ban, connect only while
    corrections flow, and reconnect without re-surveying. Also recovers f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
2026-11-07 Serve corrections directly over WiFi, with the caster as backup
    Rovers on the same network can now connect to the base on port 2101 and
    receive the same corrections it uploads to the caster. That needs no
    internet, reservation or password, so the base now does its job with the
    caster settings empty, and only warns that there is no backup.
    A rover that stalls is dropped rather than waited for, so it cannot hold up
    the GPS module or the upload.
    Adds a build for the ESP32-C3 Super Mini, with WiFi capped at 8.5 dBm because
    many of these boards are reported to lose it at full power.
2026-11-07 Say under the Save button why settings were not saved
    A new board refuses to save until it has a page password, but the page put
    that reason at the bottom of the next section, scrolled away from it, and
    said it was restarting either way. So saving looked like it did nothing.
    The answer now shows under the button, "Restarting" only follows a save
    that worked, and on a new board the page password is marked as required.
2026-11-07 Give the base's page tabs, a map and a sky view
    The page is now Overview, Map, Satellites, Position, Settings and
    Maintenance, in light and dark, and fits a phone.
    - Map: the base on satellite or street imagery. Leaflet 1.9.4 is stored on
    the board compressed, checked against its published hashes, so only the
    imagery comes from the internet.
    - Satellites: a sky plot and signal bars from UBX-NAV-SAT, polled every 5
    seconds. UBX messages up to 1024 bytes are now read, since the list is
    12 bytes a satellite.
    - Position: copy where the module is now into a fixed position, at the
    full precision it reports. The status now gives the position as exact
    decimals, with the module's extra d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
2026-11-08 Set the base's fixed position on a map, and explain its height
    The Position page's Fixed form gets a satellite map: tap where the
    antenna is, or drag the pin, and the latitude and longitude follow.
    The module's own position is a blue dot, the position in use a green
    ring, and the page warns when the pin is 5 m or more from the module.
    The height can be given above sea level as well as above the
    ellipsoid. The firmware now reports the module's height above sea level
    from NAV-HPPOSLLH, so the page converts with the module's own figure
    for here and says what it is. Use the current height copies just the
    height, for a surveyed height with a position picked on the map. A short
    explanation says w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
2026-11-08 Show what the base hears on each band, and turn its second band on from the page
    The base sent corrections with L1 only, so the mower stayed at RTK float. The
    firmware never set which bands the module tracks, so nothing showed it.
    - Reads the module's band settings (CFG-VALGET) once a minute and the signals
    it hears (NAV-SIG) every 5 seconds.
    - The Satellites tab gets a Bands card: per constellation, how many signals on
    each band, how strong, and whether the band is switched on. The Overview
    shows the counts.
    - A SINGLE_BAND warning, on the page and in the reported status, once fewer
    than half as many second-band signals as first-band ones are heard for about
    15 seconds.
    - "Turn t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
2026-11-09 Add enclosure design sources and ignore generated CAD exports
